ercoppa/GardeningBot/StaticGargeningBot/README.md

# A gardening bot based on Arduino Mini Pro (5v/16mhz)
