ercoppa/GardeningBot/WifiGardeningBot/conf.h

#ifndef __CONF_H__
#define __CONF_H__

// WiFi Settings
#define WLAN_SSID       "XXX"      // your network SSID (name)
#define WLAN_PASSWD     "XXX"      // your network key

// Telegram
#define BOT_TOKEN "XXX"  // your Bot Token (Get from Botfather)
#define CHAT_ID   "XXX"  // Chat ID of where you want the message to go (You can use MyIdBot to get the chat ID)

#endif
